anqixxx/lora-pet-tracker/app/assets/images/cat.jpg

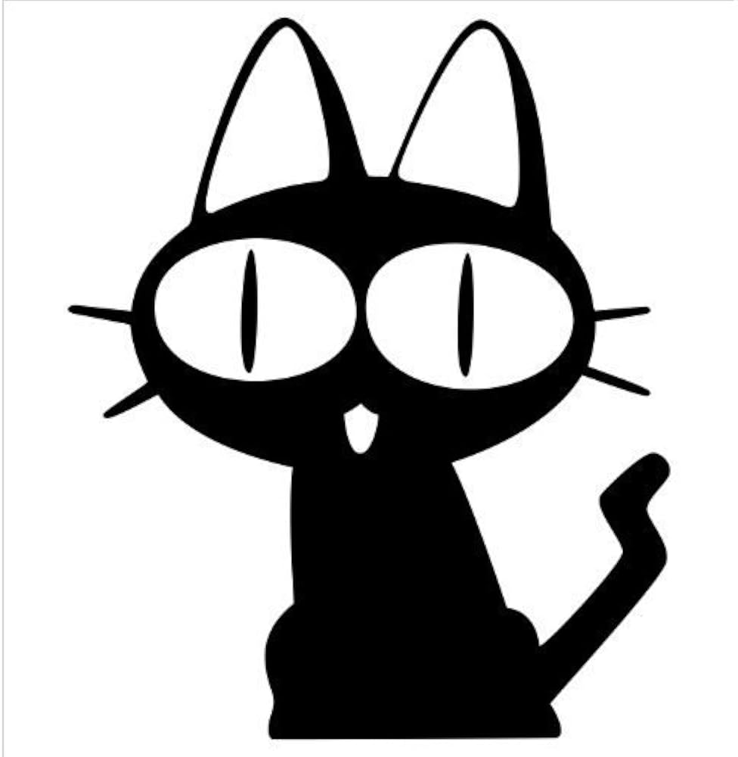
app/assets/images/cat.jpg
