anqixxx/lora-pet-tracker/app/assets/readme/homepage.png

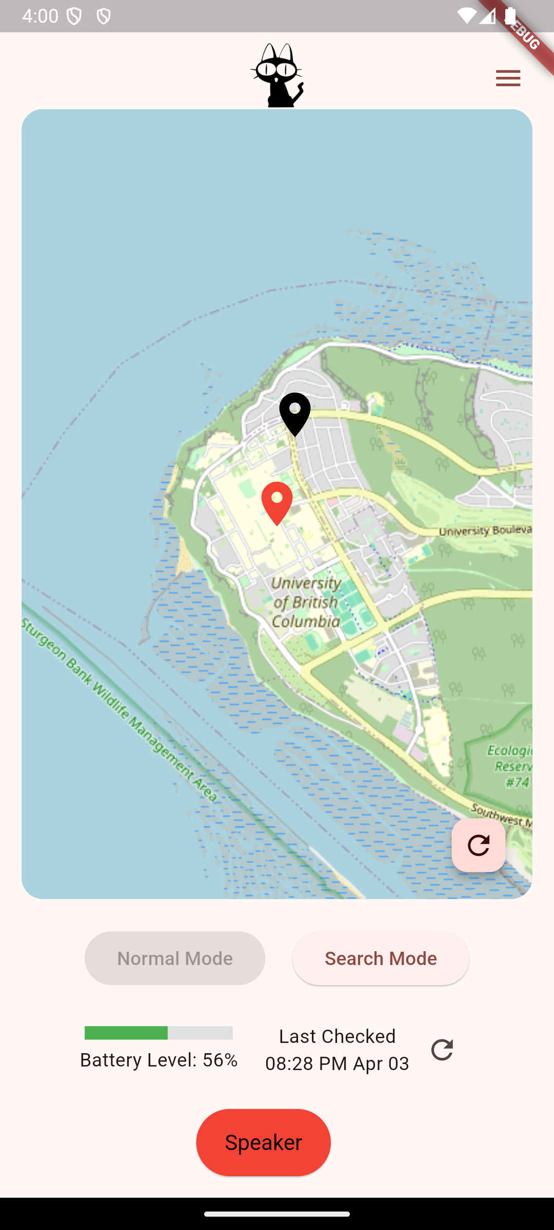
app/assets/readme/homepage.png
