anqixxx/lora-pet-tracker/app/assets/readme/history.png

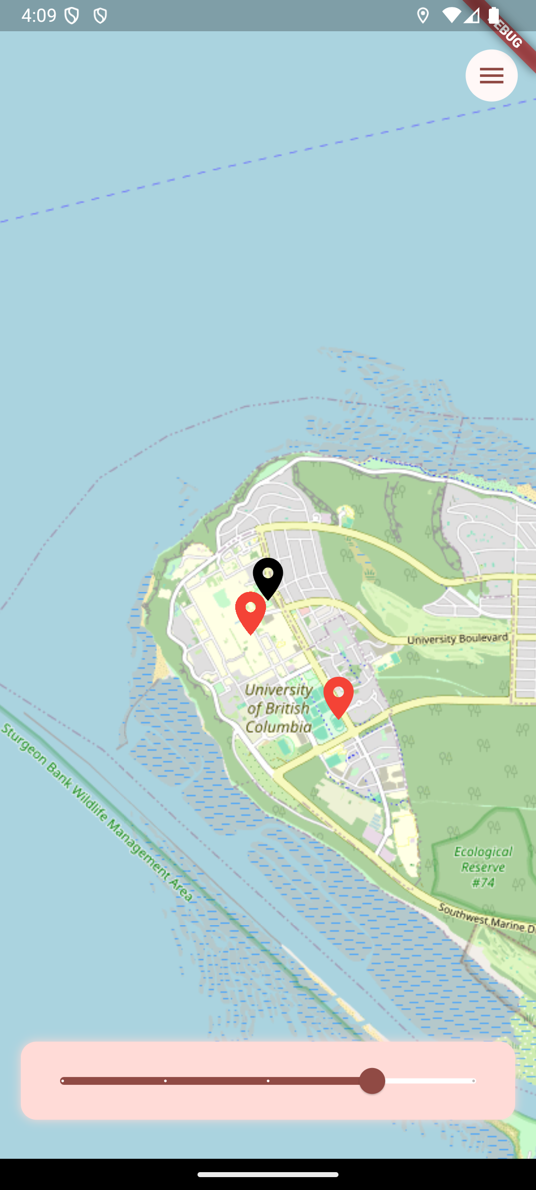
app/assets/readme/history.png
