anqixxx/lora-pet-tracker/node/hardware/Schematic PDF.pdf

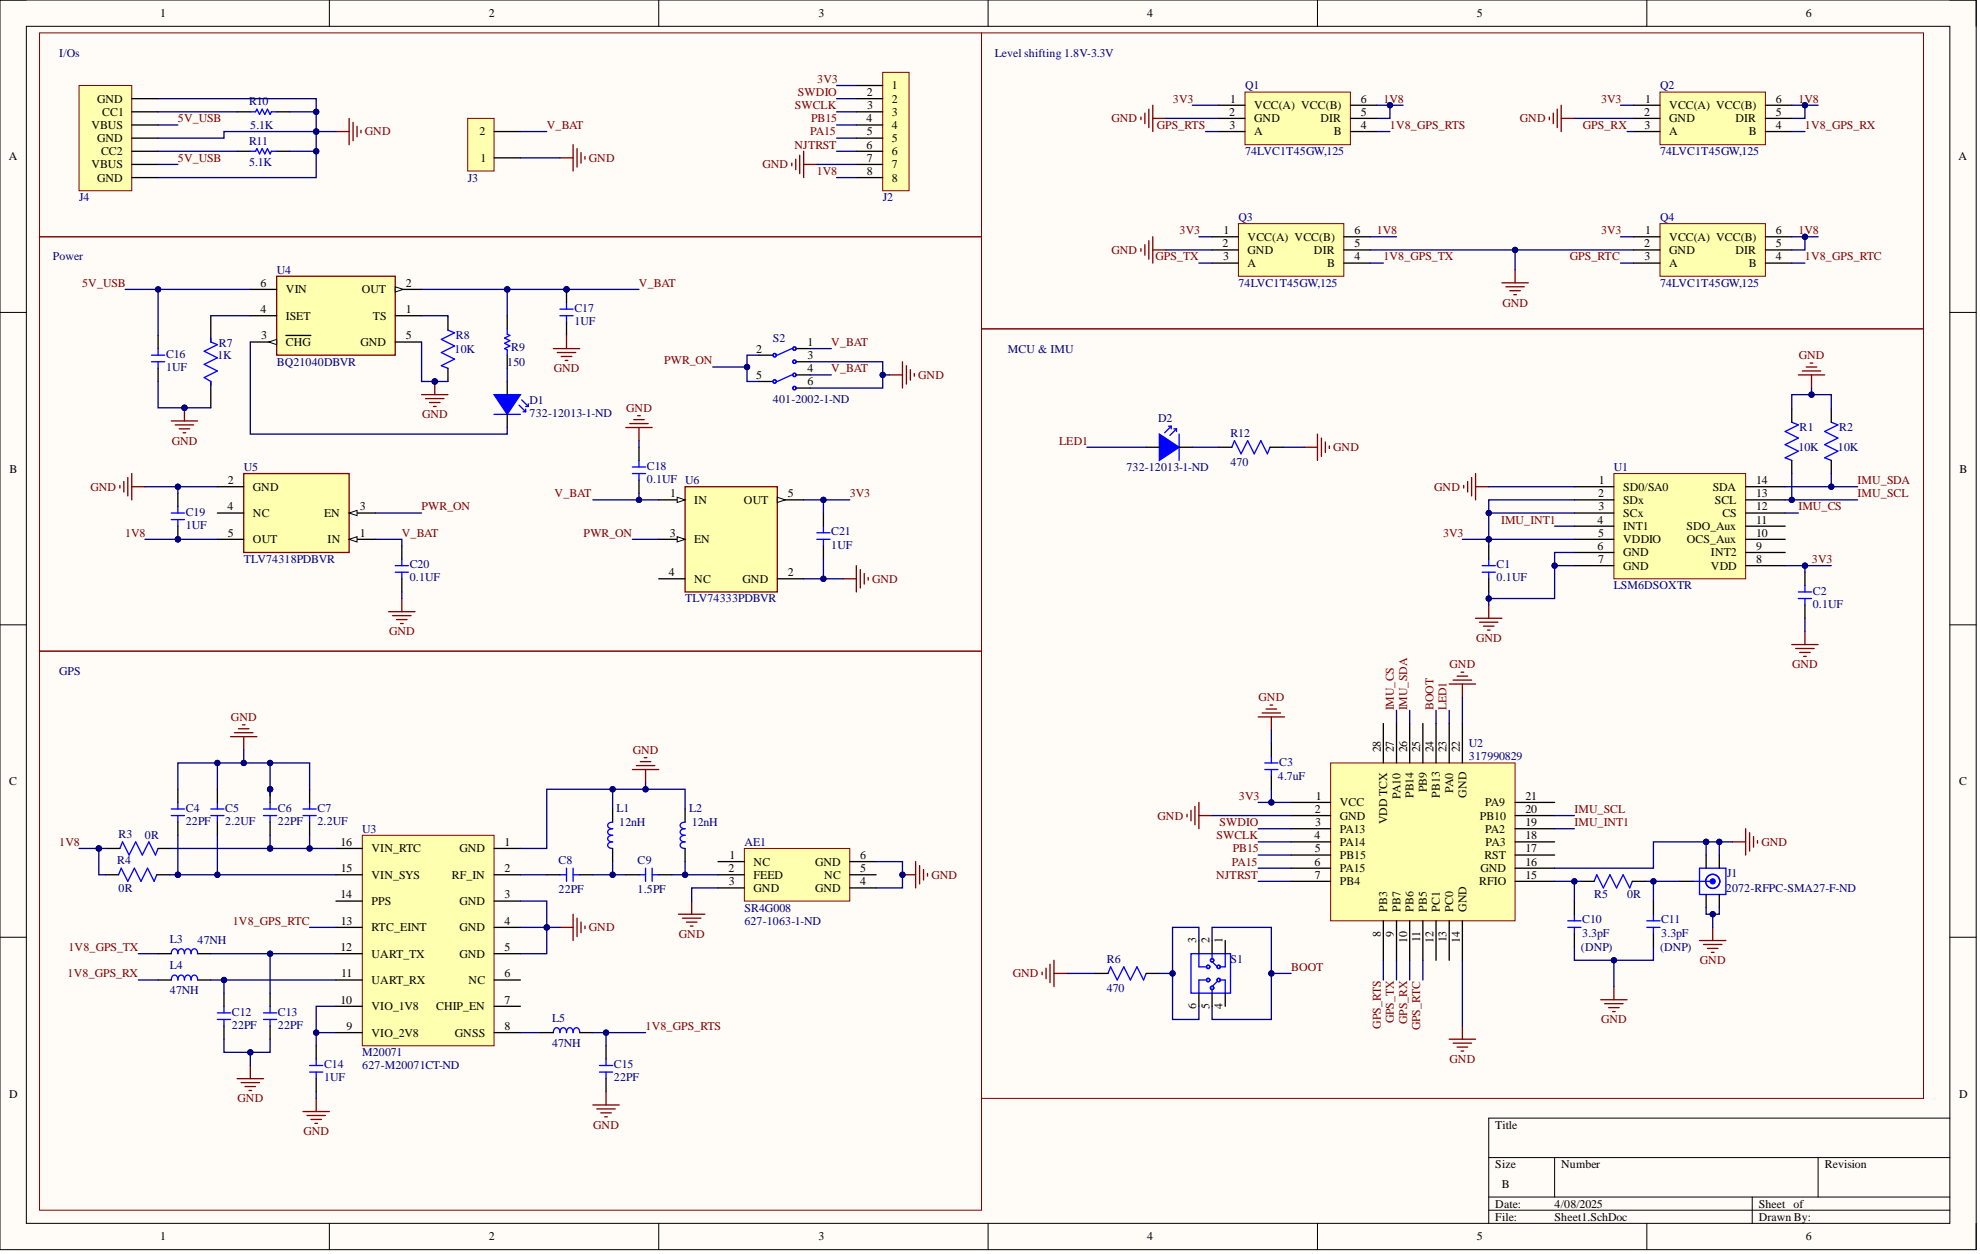
[picture p14: page 1]

5V_USB 5.1K
