anqixxx/lora-pet-tracker/(commit log)

2024-11-13 changed domain name, added printouts for firebase
2024-11-14 added battery
2024-12-02 Node and server code for prototype testing
2025-01-07 custom IMU library
2025-01-29 updated adaptive command parsing, added a battery command for server code
2025-02-13 implemented dynamic battery
2025-03-05 added battery fetcher
2025-03-05 deleted extra print statement
2025-03-05 floating action button
2025-04-02 fixed arduino code, uploaded to base station, updated base code for server query
2025-04-03 lowkey idk im tired
2025-04-03 lowkey idk im tired again
2025-04-03 time filtering/sorting issues, fixed
2025-04-06 arduino naming
2025-04-07 added battery and gps request, polished it up
2025-04-07 maxed out Tx power for test, properly defined TX pin
2025-04-09 whoops moved code in wrong place
    [node.ino]
2025-04-09 added search tx power and sleep mode message
2025-04-09 Added PCB hardware files, updated base station and node code
    [BOM.csv]
